OliverHi/MultiuseSensorPlatform/Pictures/IMG004.jpg

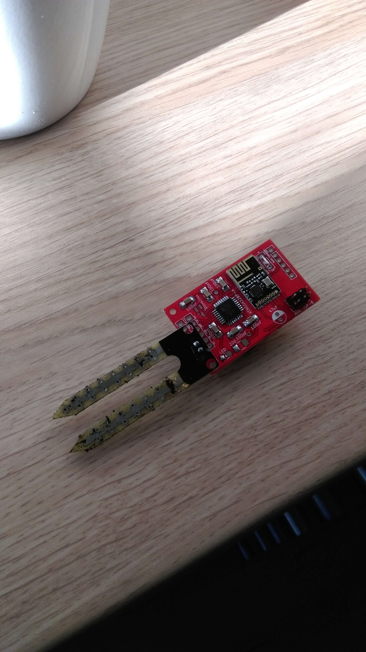
Pictures/IMG004.jpg
