OliverHi/MultiuseSensorPlatform/Pictures/IMG002.jpg

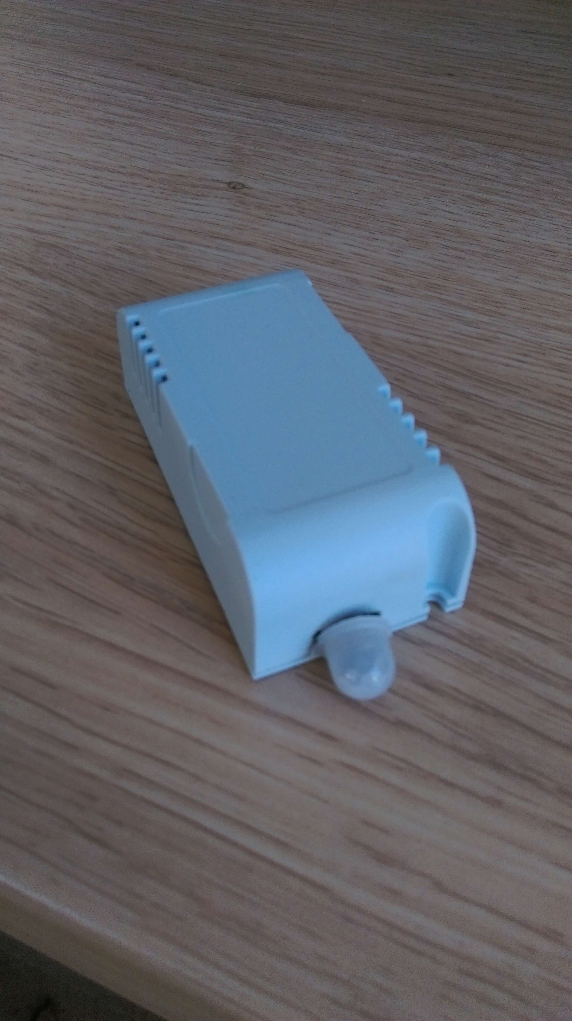
Pictures/IMG002.jpg
