OliverHi/MultiuseSensorPlatform/README.md

# MultiuseSensorPlatform
a mysensor based platform for a suite of different possible sensors

More information can be found [here](https://www.openhardware.io/view/261/OH-Mini-Multi-use-Sensor-Platform).
