OliverHi/MultiuseSensorPlatform/Pictures/IMG001.jpg

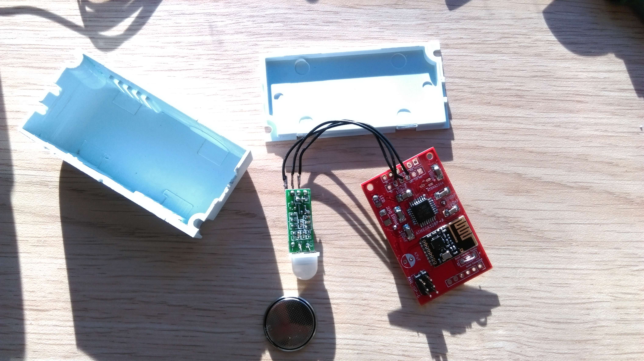
Pictures/IMG001.jpg
