OliverHi/MultiuseSensorPlatform/Pictures/IMG003.jpg

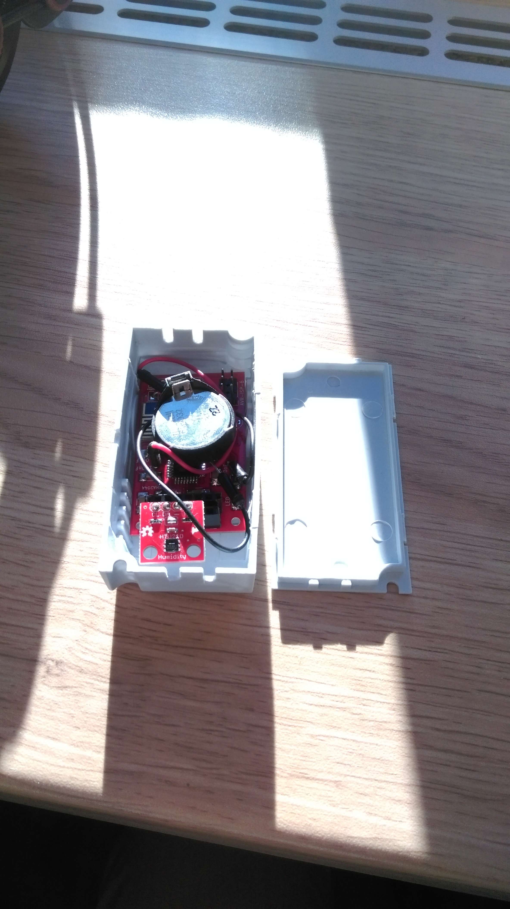
Pictures/IMG003.jpg
