OliverHi/MultiuseSensorPlatform/Hardware/MiniSensor.pdf

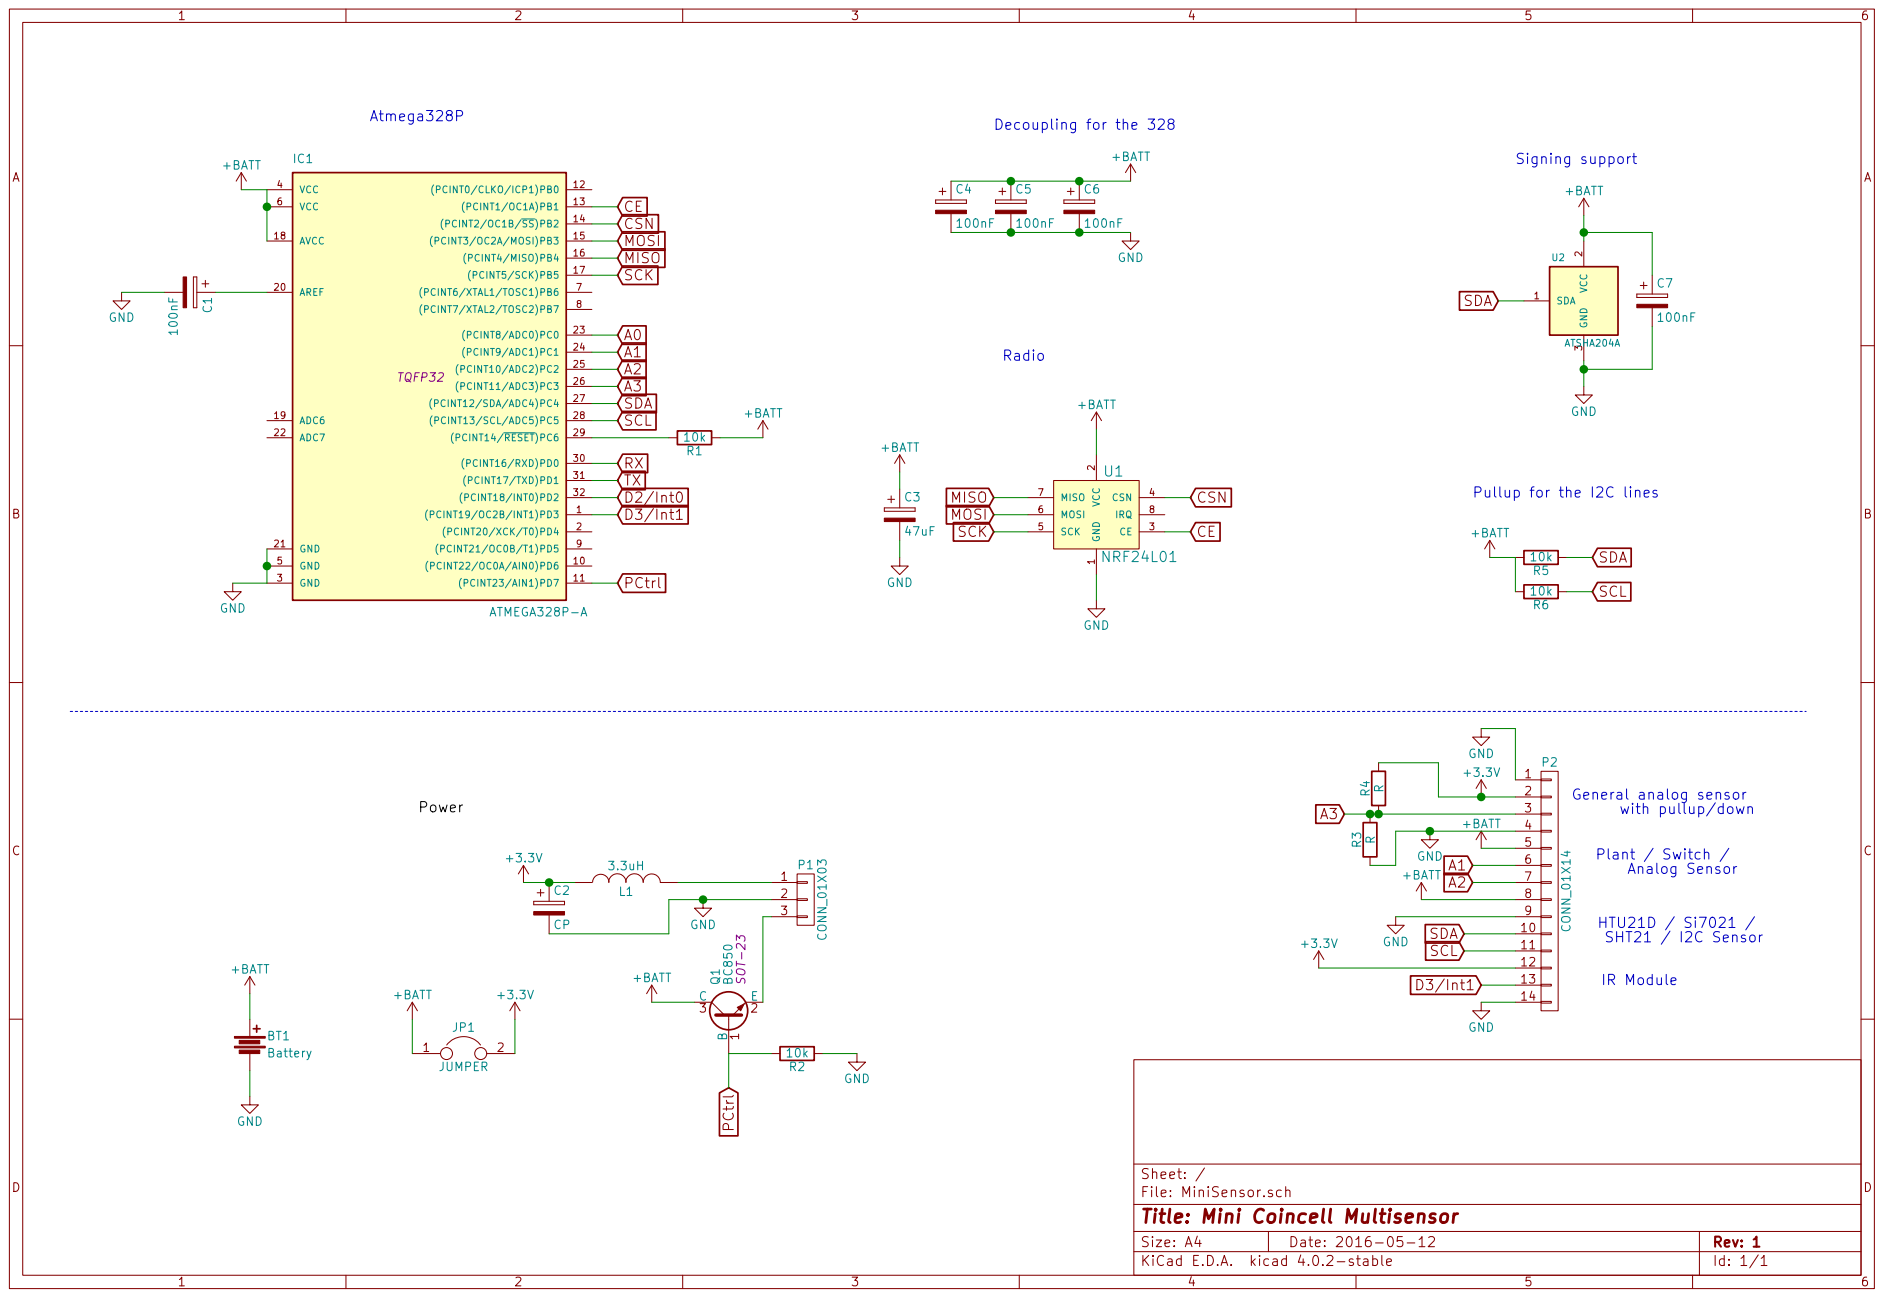
[picture p5: page 1]

Decoupling for the 328 Radio Atmega328P

Pullup for the I2C lines C4

with pullup/down GND SDA

2 CE 3 CSN 4 SCK 5 MOSI 6 MISO 7

Id: 1/1 Title: Mini Coincell Multisensor File: MiniSensor.sch Sheet: /
