OliverHi/MultiuseSensorPlatform/Hardware/MiniSensor.kicad_pcb

## KiCad design Hardware/MiniSensor.kicad_pcb (2016-07-04)

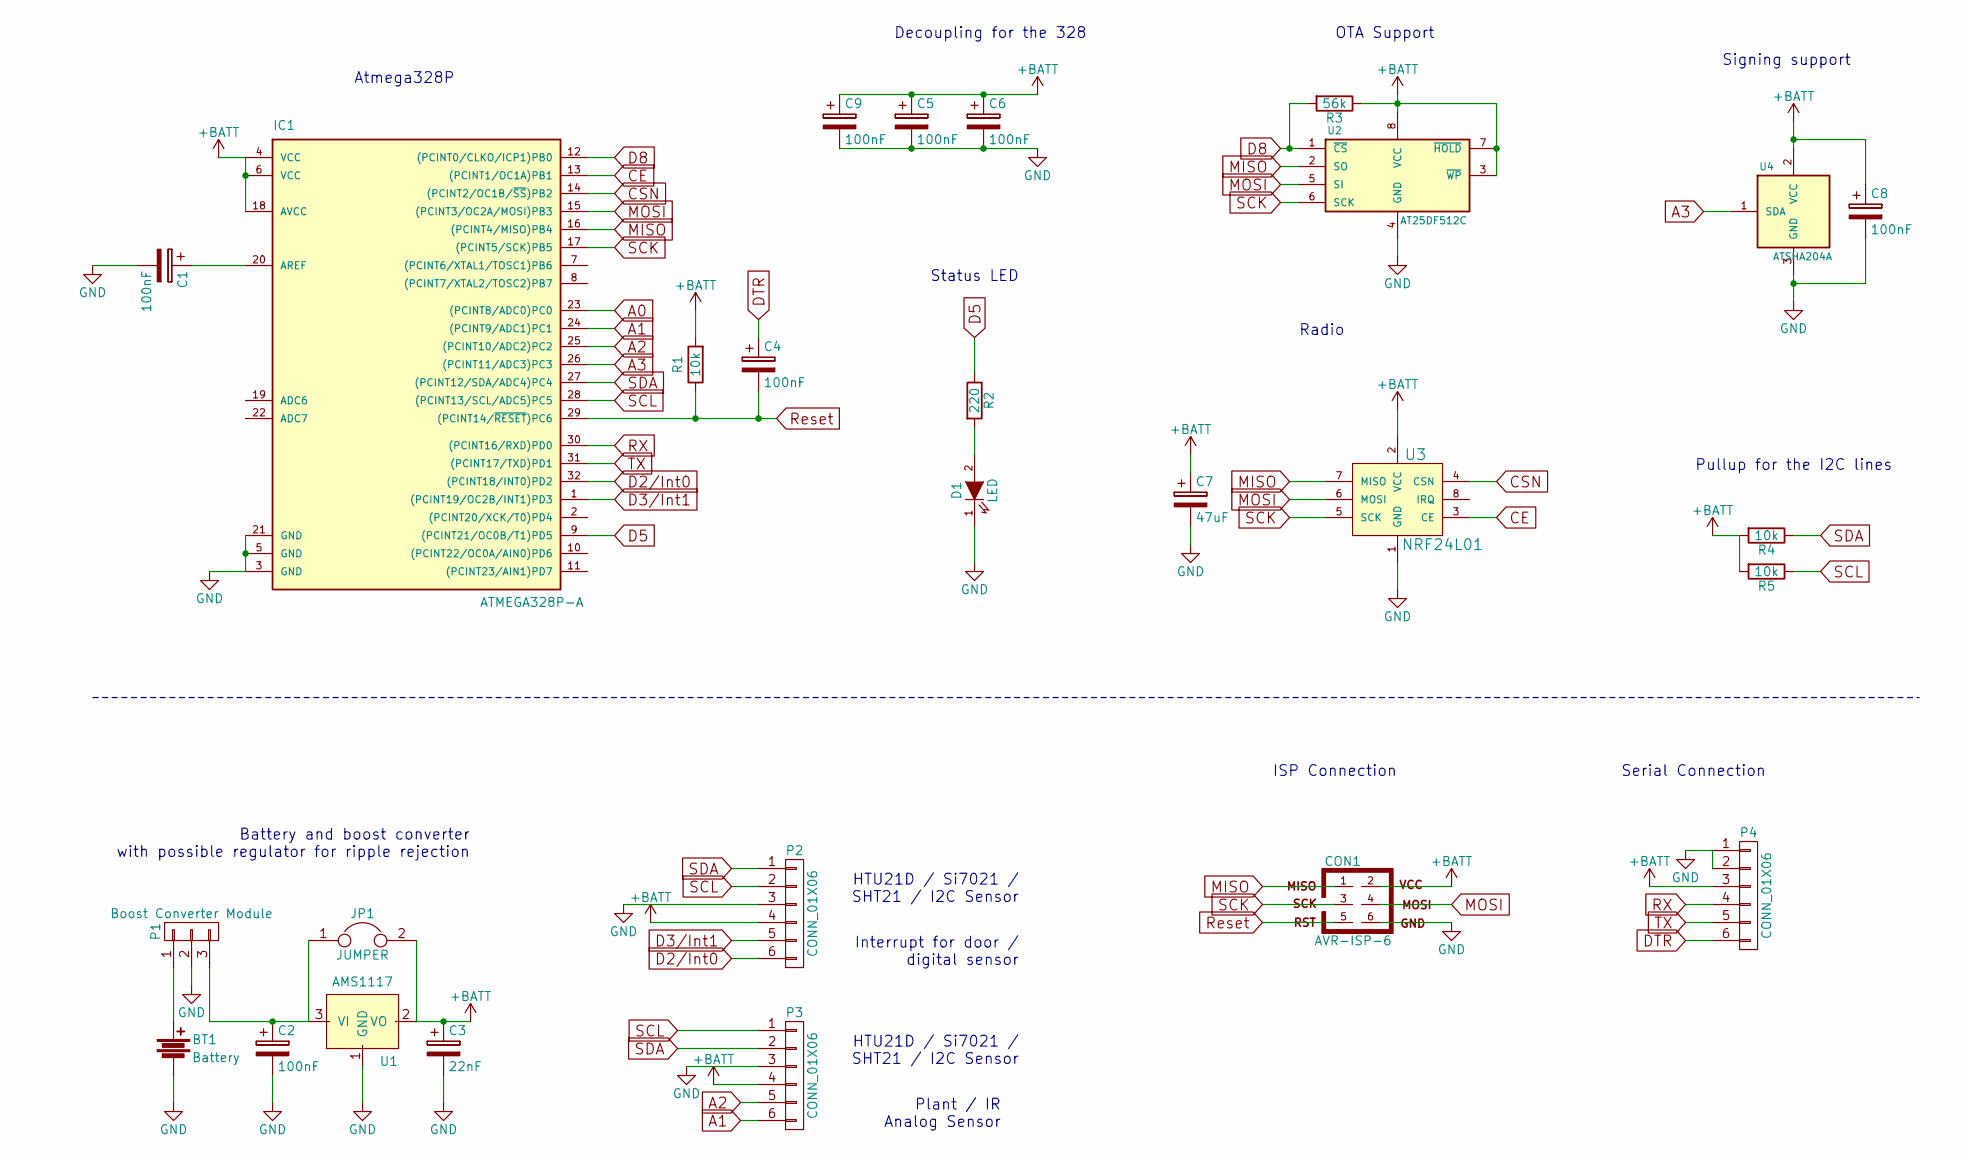
[picture p6: schematic MiniSensor.sch, Mini Coincell Multisensor]

Parts:
BT1: Battery; CR2032 Battery Holder
C1, C2, C4, C5, C6, C8, C9: 100nF; C_1210_HandSoldering
C3: 22nF; C_1210_HandSoldering
C7: 47uF; C_Radial_D5_L6_P2.5
CON1: AVR-ISP-6; Pin_Header_Straight_2x03
D1: LED; LED_1206
IC1: ATMEGA328P-A; TQFP-32_7x7mm_Pitch0.8mm
JP1: JUMPER; 2_pin_solder_jumper_smd
P1: Boost Converter Module; Pin_Header_Straight_1x03
P2, P3, P4: CONN_01X06; Pin_Header_Straight_1x06
R1, R4, R5: 10k; R_1210_HandSoldering
R2: 220; R_1210_HandSoldering
R3: 56k
U1: AMS1117; SOT-223
U2: AT25DF512C
U3: NRF24L01; NRF24L01-SMD
U4: ATSHA204A; SOT-23_Handsoldering

Connections:
+BATT: C3.1, C5.1, C6.1, C7.1, C8.1, C9.1, CON1.2, IC1.4 (VCC), IC1.6 (VCC), IC1.18 (AVCC), JP1.2, P2.4, P3.4, P4.3, R1.2, R3.1, R4.2, R5.2, U1.2 (VO), U2.3 (~WP), U2.7 (~HOLD), U2.8 (VCC), U3.2 (VCC), U4.2 (VCC)
A0: IC1.23 ((PCINT8/ADC0)PC0)
A1: IC1.24 ((PCINT9/ADC1)PC1), P3.6
A2: IC1.25 ((PCINT10/ADC2)PC2), P3.5
A3: IC1.26 ((PCINT11/ADC3)PC3), U4.1 (SDA)
CE: IC1.13 ((PCINT1/OC1A)PB1), U3.3 (CE)
CSN: IC1.14 ((PCINT2/OC1B/~SS~)PB2), U3.4 (CSN)
D2/Int0: IC1.32 ((PCINT18/INT0)PD2), P2.6
D3/Int1: IC1.1 ((PCINT19/OC2B/INT1)PD3), P2.5
D5: IC1.9 ((PCINT21/OC0B/T1)PD5), R2.1
D8: IC1.12 ((PCINT0/CLKO/ICP1)PB0), R3.2, U2.1 (~CS)
DTR: C4.1, P4.6
GND: BT1.2, C1.2, C2.2, C3.2, C5.2, C6.2, C7.2, C8.2, C9.2, CON1.6, D1.1 (K), IC1.3 (GND), IC1.5 (GND), IC1.21 (GND), P1.2, P2.3, P3.3, P4.1, P4.2, U1.1 (GND), U2.4 (GND), U3.1 (GND), U4.3 (GND)
MISO: CON1.1, IC1.16 ((PCINT4/MISO)PB4), U2.2 (SO), U3.7 (MISO)
MOSI: CON1.4, IC1.15 ((PCINT3/OC2A/MOSI)PB3), U2.5 (SI), U3.6 (MOSI)
unnamed: BT1.1, P1.1
unnamed: C1.1, IC1.20 (AREF)
unnamed: C2.1, JP1.1, P1.3, U1.3 (VI)
unnamed: D1.2 (A), R2.2
RX: IC1.30 ((PCINT16/RXD)PD0), P4.4
Reset: C4.2, CON1.5, IC1.29 ((PCINT14/~RESET~)PC6), R1.1
SCK: CON1.3, IC1.17 ((PCINT5/SCK)PB5), U2.6 (SCK), U3.5 (SCK)
SCL: IC1.28 ((PCINT13/SCL/ADC5)PC5), P2.2, P3.1, R5.1
SDA: IC1.27 ((PCINT12/SDA/ADC4)PC4), P2.1, P3.2, R4.1
TX: IC1.31 ((PCINT17/TXD)PD1), P4.5

Notes on the sheet:
HTU21D / Si7021 / SHT21 / I2C Sensor
Plant / IR Analog Sensor
Signing support
Pullup for the I2C lines
Decoupling for the 328
Radio
Atmega328P
OTA Support
Interrupt for door / digital sensor
ISP Connection
Serial Connection
Status LED
Battery and boost converter with possible regulator for ripple rejection

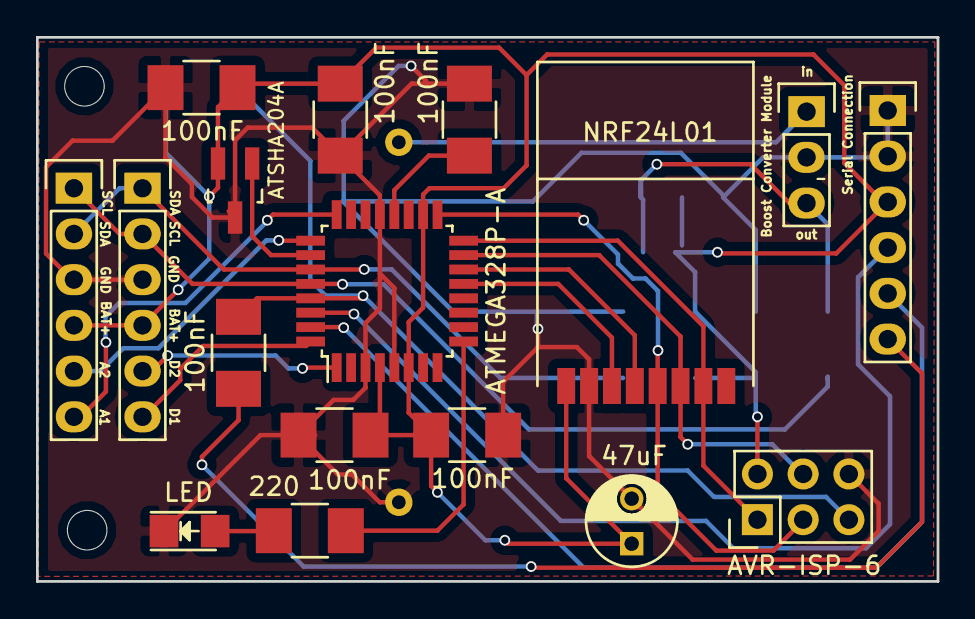
[picture p7: board MiniSensor.kicad_pcb from above]

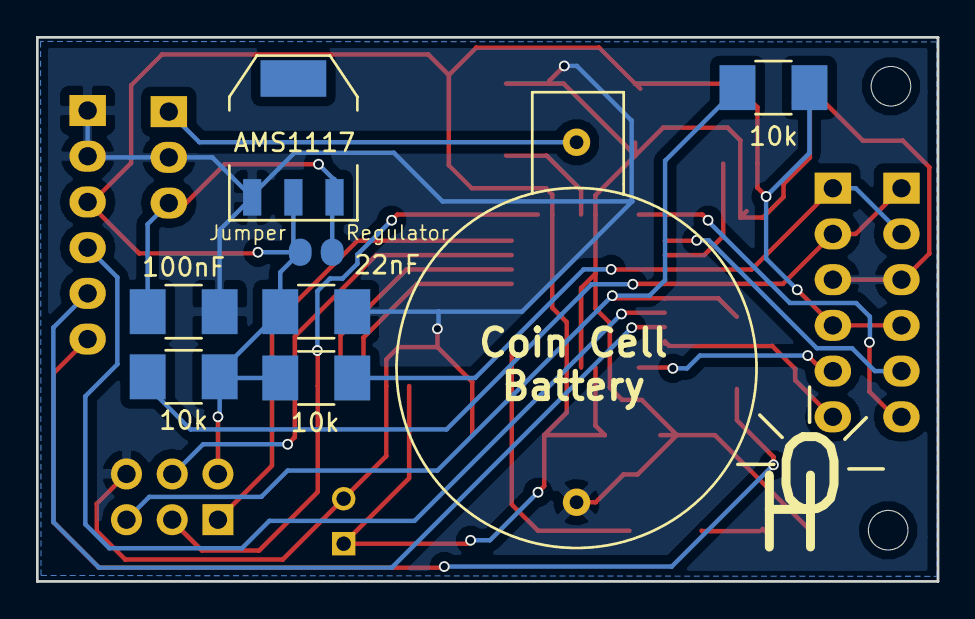
[picture p8: board MiniSensor.kicad_pcb from below]

Board: 2 copper layers, 50.0 x 30.2 mm, 25 parts (8 on the bottom side), 23 nets.
