OliverHi/MultiuseSensorPlatform/(commit log)

2016-05-19 added first version of the schematics
    [MiniSensor.kicad_pcb, MiniSensor.sch]
2016-06-21 updated schematics, moved to hardware folder
    [MiniSensor.kicad_pcb, MiniSensor.sch]
2016-07-04 schematics updated to final version 1, gerber export added
    [MiniSensor.kicad_pcb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]
2016-09-16 added sketch for a motion sensor
2016-10-02 added voltage readings to motion sketch, the sketch now also sends an off signal right after an on signal instead of letting the controller do that
2016-10-27 updated documentation, added button/door sketch
2016-10-27 added simple debouncing to the button/door sketch
